hmersch1996/Brazo-Robotico-de-Simulacion-de-Soldadura/README.md

# Brazo-Robotico-de-Simulacion-de-Soldadura
En este repositorio se tienen los documentos necesarios para la implementacion de un brazo robotico de 5 grados de libertad que simula un proceso de soldadura electrica. Este brazo cuenta con una camara que implementara vision artificial para calcular la trayectoria. El control del robot se realizara a traves de una GUI por computadora

Para las articulaciones del brazo se utilizaron servomotores del tipo MG995 en conjunto con soportes para servomotores, como se puede apreciar en las siguientes imagenes:





La camara utilizada es una webcam 1080p, 30fps, como el de la siguiente imagen:
