hmersch1996/Brazo-Robotico-de-Simulacion-de-Soldadura/STLs/L298N_Case_1.0.3b.stl

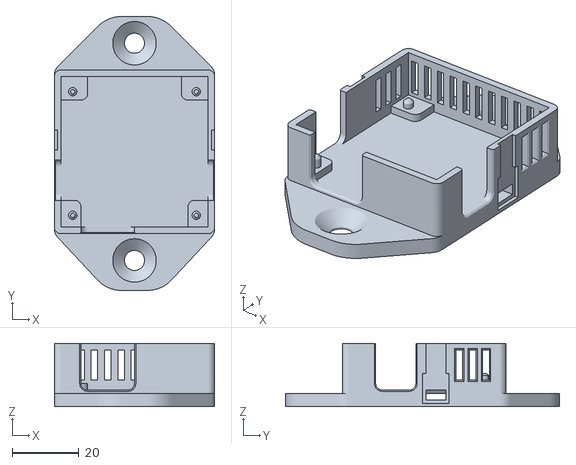
[picture p16: CAD file, 2022-07-27]
STLs/L298N_Case_1.0.3b.stl
48.0 x 82.0 x 19.0
