hmersch1996/Brazo-Robotico-de-Simulacion-de-Soldadura/STLs/arduino_mega_bottom.stl

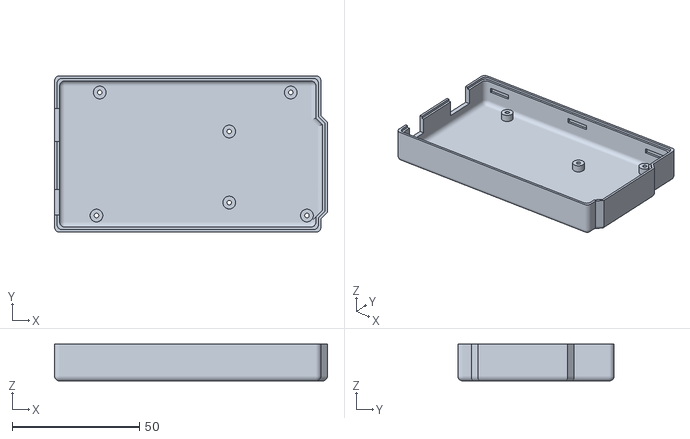
[picture p17: CAD file, 2022-07-27]
STLs/arduino_mega_bottom.stl
107.1 x 61.3 x 14.5
