hmersch1996/Brazo-Robotico-de-Simulacion-de-Soldadura/STLs/soporte pincel inferior.stl

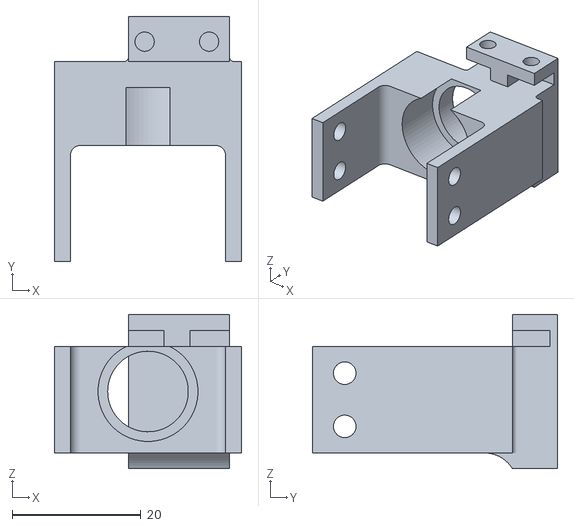
[picture p18: CAD file, 2022-07-27]
STLs/soporte pincel inferior.stl
29.0 x 38.0 x 23.9
