hmersch1996/Brazo-Robotico-de-Simulacion-de-Soldadura/STLs/L298N_Case_1.0.3c.stl

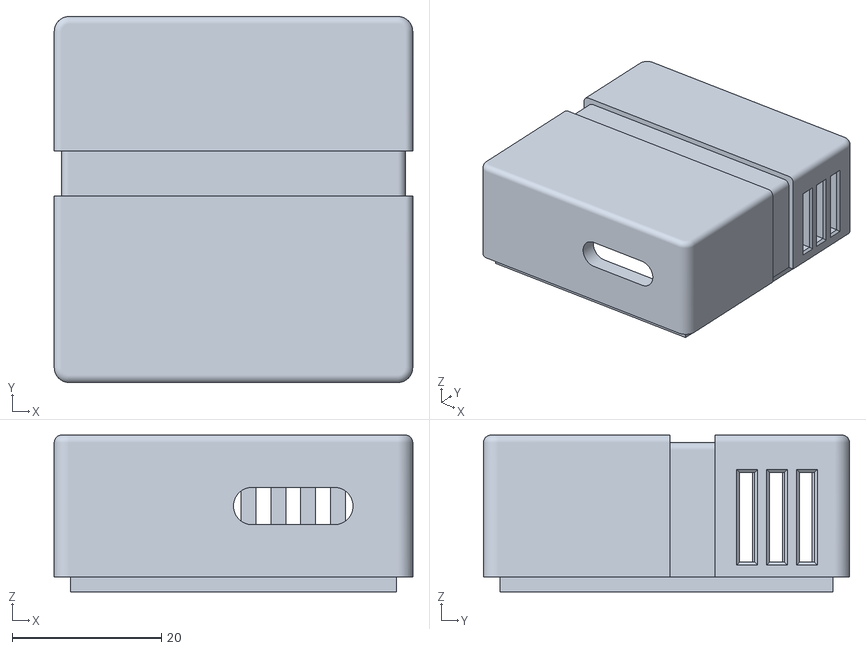
[picture p19: CAD file, 2022-07-27]
STLs/L298N_Case_1.0.3c.stl
48.0 x 49.0 x 21.0
