hmersch1996/Brazo-Robotico-de-Simulacion-de-Soldadura/STLs/arduino_mega_top.stl

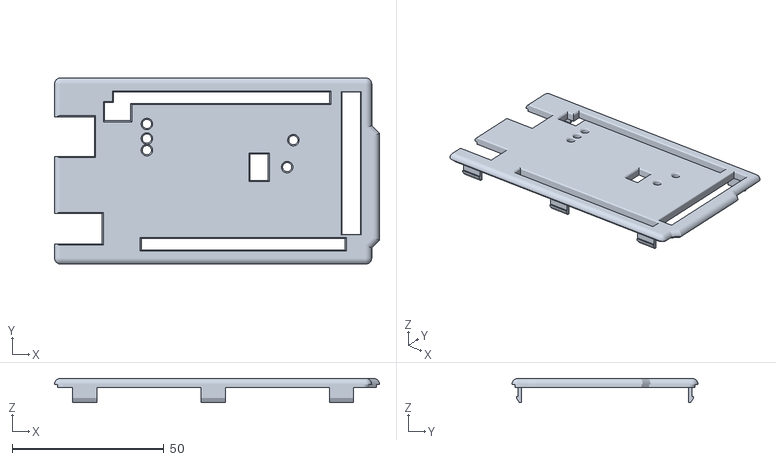
[picture p20: CAD file, 2022-07-27]
STLs/arduino_mega_top.stl
107.1 x 61.3 x 8.00
