hmersch1996/Brazo-Robotico-de-Simulacion-de-Soldadura/STLs/soporte camara.stl

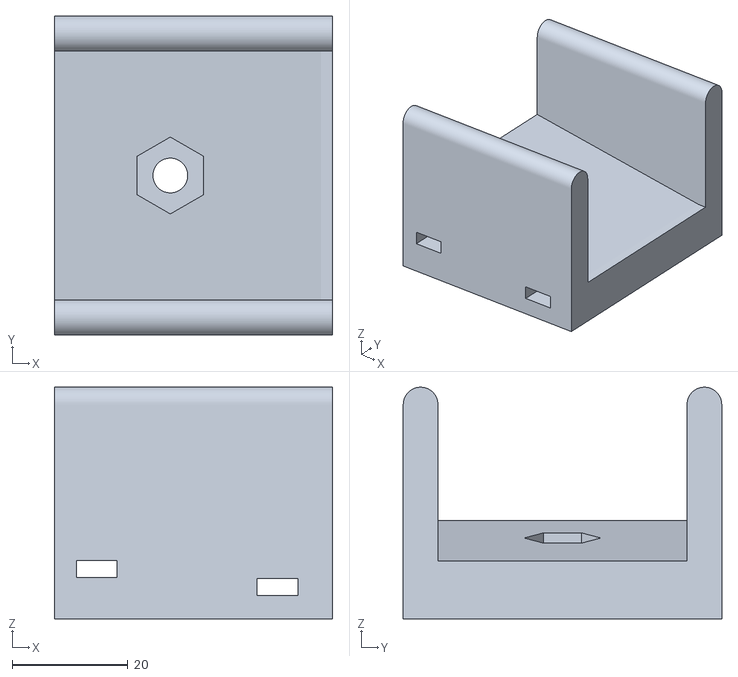
[picture p21: CAD file, 2022-07-27]
STLs/soporte camara.stl
48.0 x 55.0 x 40.0
