hmersch1996/Brazo-Robotico-de-Simulacion-de-Soldadura/STLs/soporte pincel superior.stl

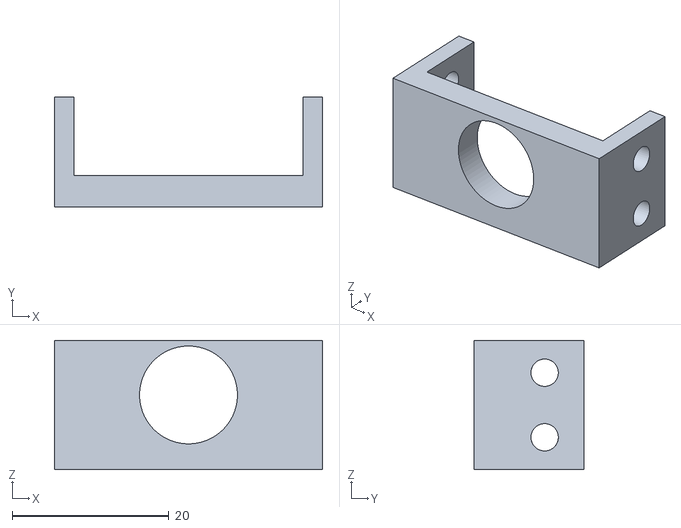
[picture p22: CAD file, 2022-07-27]
STLs/soporte pincel superior.stl
34.2 x 14.0 x 16.5
